AlieksieievYurii/AutoWaterPump/water-pump.png

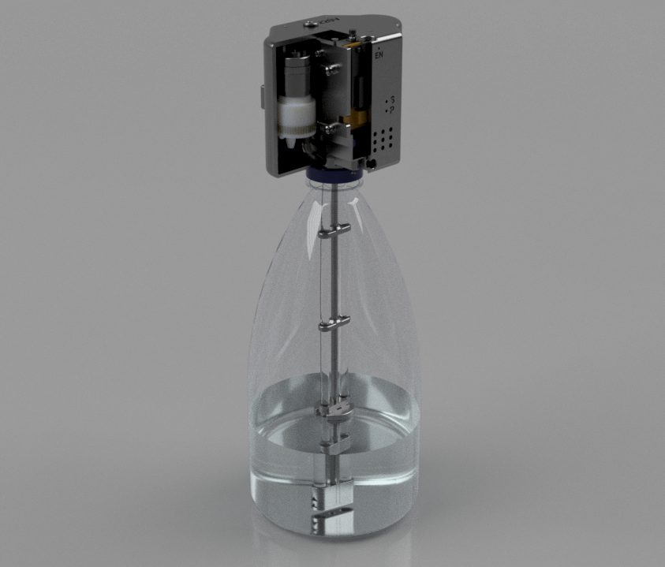
water-pump.png
