AlieksieievYurii/AutoWaterPump/parts/adapter.obj

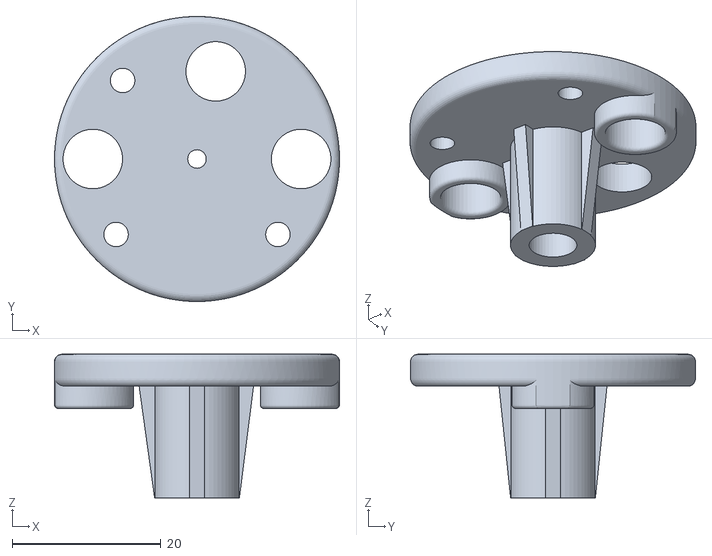
[picture p2: CAD file, 2024-06-25]
parts/adapter.obj
38.3 x 38.3 x 19.3
