AlieksieievYurii/AutoWaterPump/parts/plug-a.obj

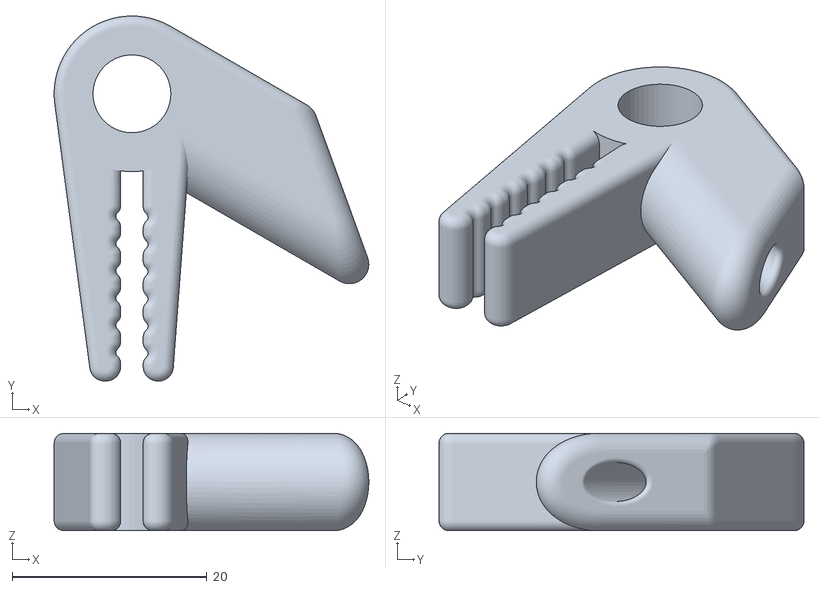
[picture p3: CAD file, 2024-06-25]
parts/plug-a.obj
32.3 x 37.5 x 10.0
