AlieksieievYurii/AutoWaterPump/parts/nozzle-b.obj

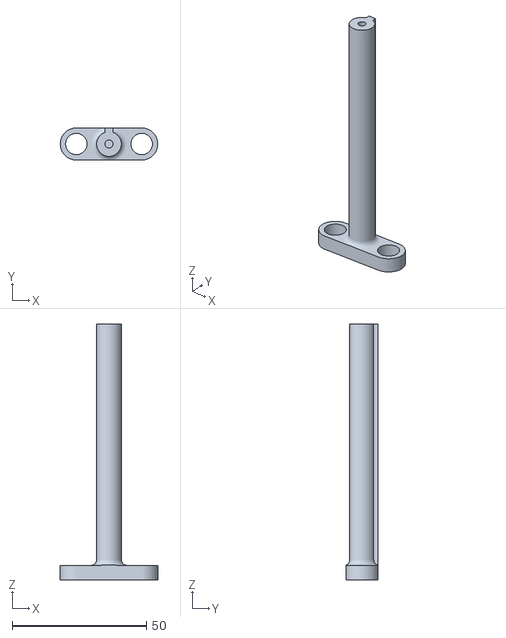
[picture p4: CAD file, 2024-06-25]
parts/nozzle-b.obj
36.4 x 12.0 x 95.5
