AlieksieievYurii/AutoWaterPump/parts/buoy.obj

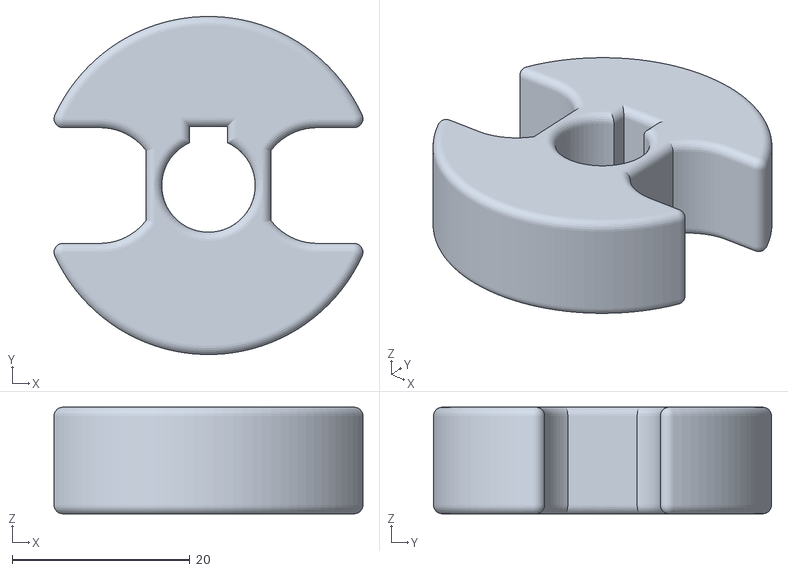
[picture p5: CAD file, 2024-06-25]
parts/buoy.obj
34.7 x 38.0 x 12.0
