AlieksieievYurii/AutoWaterPump/parts/holder.obj

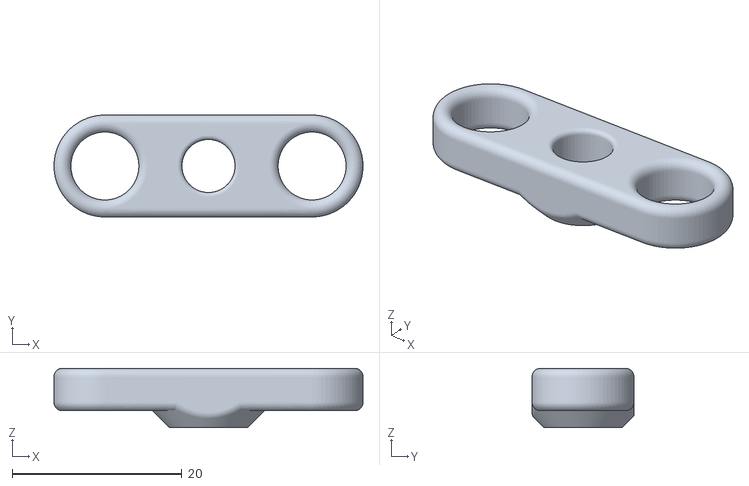
[picture p6: CAD file, 2024-06-25]
parts/holder.obj
36.4 x 12.0 x 7.00
