AlieksieievYurii/AutoWaterPump/parts/wire-adapter.obj

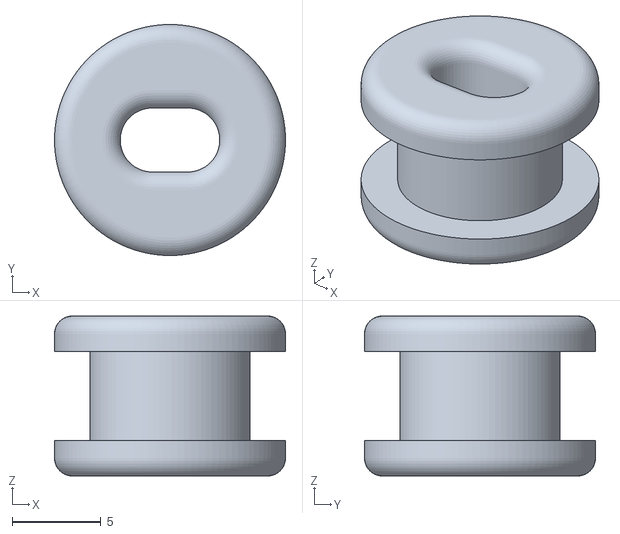
[picture p7: CAD file, 2024-06-25]
parts/wire-adapter.obj
13.0 x 13.0 x 9.00
