AlieksieievYurii/AutoWaterPump/parts/nozzle-a.obj

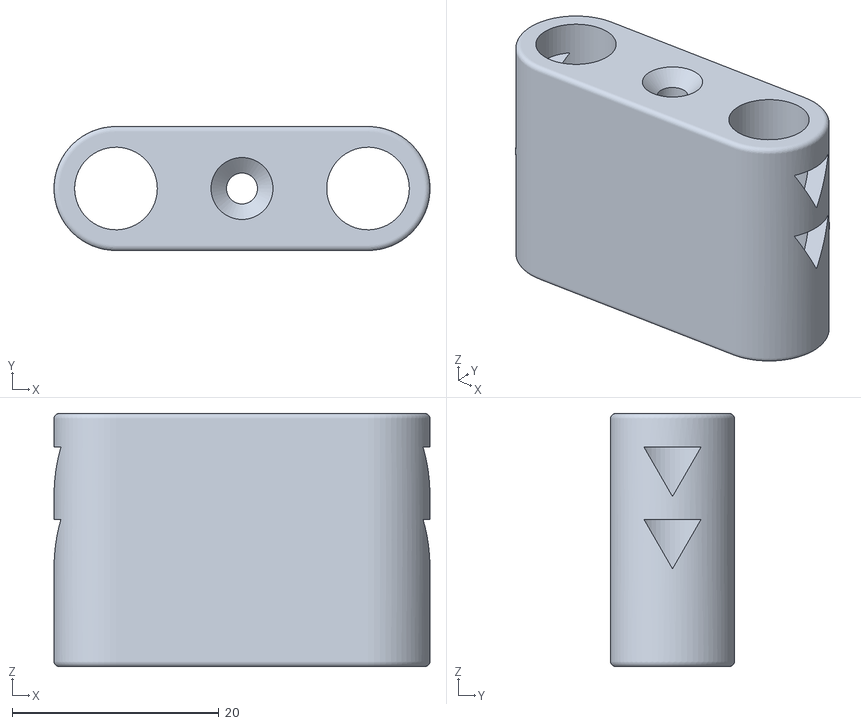
[picture p8: CAD file, 2024-06-25]
parts/nozzle-a.obj
36.4 x 12.0 x 24.5
