AlieksieievYurii/AutoWaterPump/parts/cover-d.obj

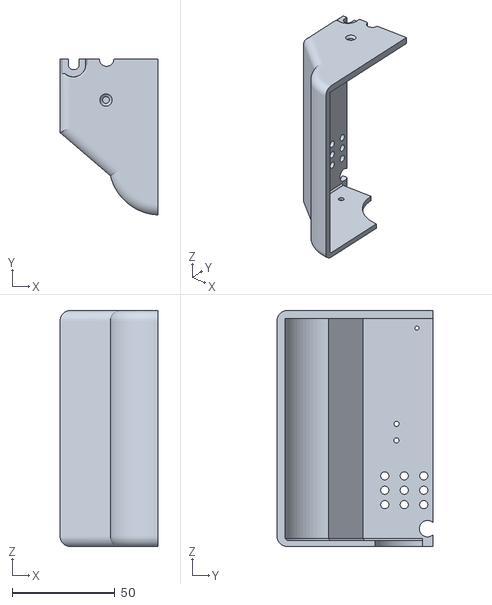
[picture p9: CAD file, 2024-06-25]
parts/cover-d.obj
47.7 x 76.0 x 115.0
