AlieksieievYurii/AutoWaterPump/parts/skeleton-c.obj

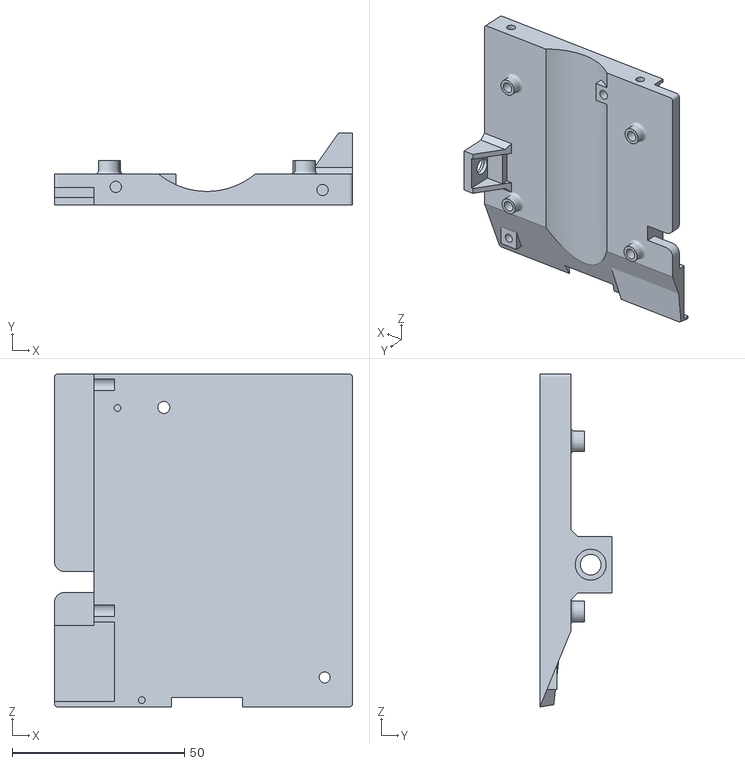
[picture p10: CAD file, 2024-06-25]
parts/skeleton-c.obj
86.5 x 21.0 x 96.6
