AlieksieievYurii/AutoWaterPump/parts/plug-b.obj

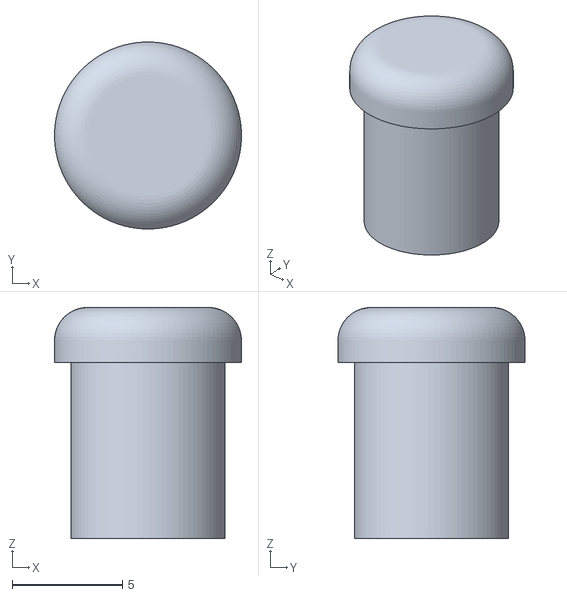
[picture p11: CAD file, 2024-06-25]
parts/plug-b.obj
8.50 x 8.50 x 10.5
