AlieksieievYurii/AutoWaterPump/parts/cover-b.obj

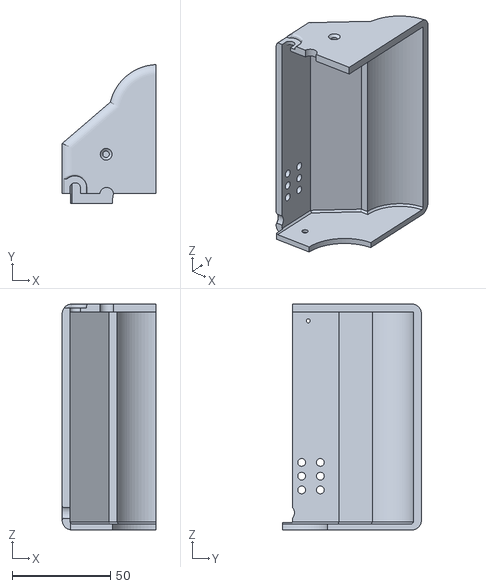
[picture p12: CAD file, 2024-06-25]
parts/cover-b.obj
47.7 x 70.7 x 115.0
