AlieksieievYurii/AutoWaterPump/parts/cover-a.obj

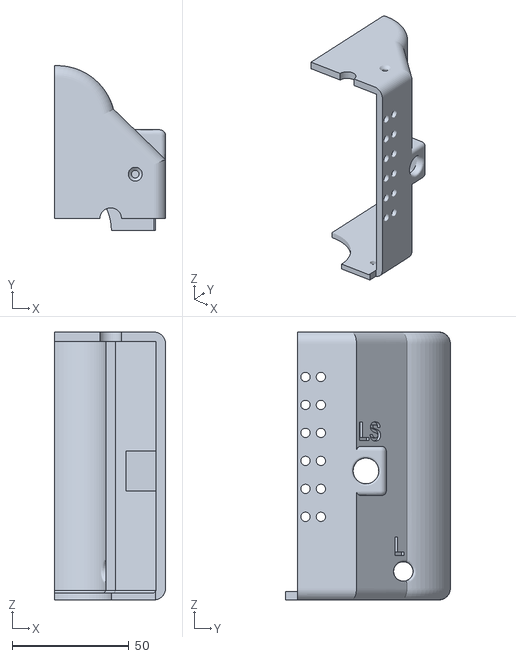
[picture p13: CAD file, 2024-06-25]
parts/cover-a.obj
47.7 x 70.7 x 115.0
