AlieksieievYurii/AutoWaterPump/parts/cover-c.obj

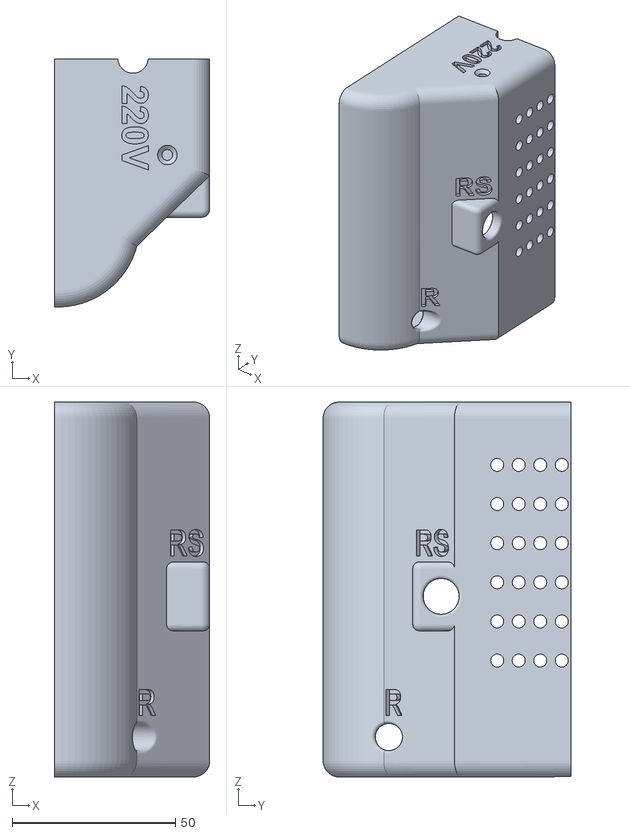
[picture p14: CAD file, 2024-06-25]
parts/cover-c.obj
47.7 x 76.0 x 115.0
