AlieksieievYurii/AutoWaterPump/parts/skeleton-a.obj

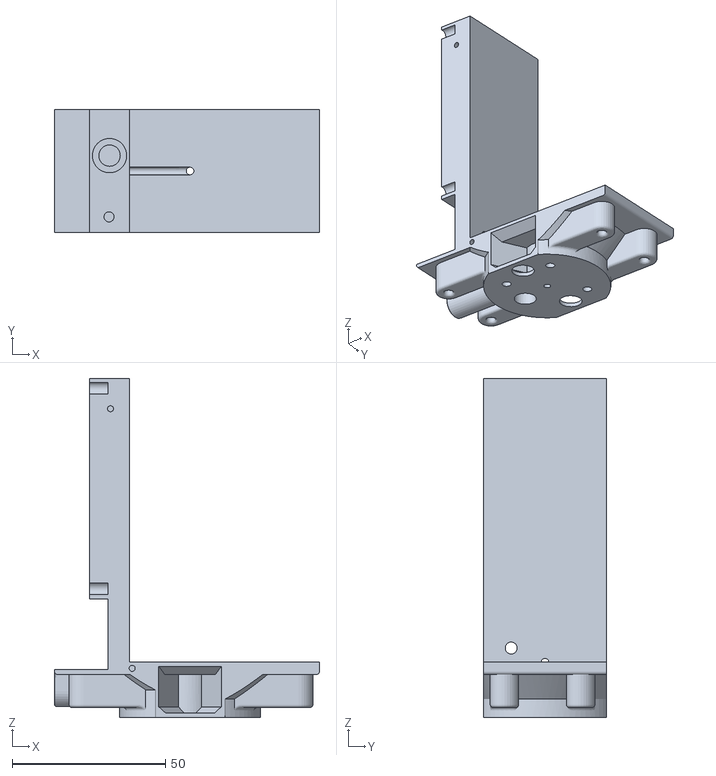
[picture p15: CAD file, 2024-06-25]
parts/skeleton-a.obj
86.5 x 40.0 x 110.6
