AlieksieievYurii/AutoWaterPump/(list of files, cad)

Other CAD files:
parts/skeleton-b.obj
