AlieksieievYurii/AutoWaterPump/(commit log)

2024-06-14 Create class responsible for motors
2024-06-14 Create class responsible for smooth state switch
2024-06-14 Create helper class to work with led/buzzer impulse
    [pulse.h]
2024-06-17 Add stop function for motor. Fix the problem regarding floating triggering
    [motor.h, src.ino]
2024-06-25 Commit parts
    [adapter.obj, buoy.obj, cover-a.obj, cover-b.obj, cover-c.obj, cover-d.obj, holder.obj, nozzle-a.obj]
2024-06-25 Add render of the water pump
2024-07-14 Fix the availability of AP during not pairing mode
    [src.ino]
2024-07-14 Add schematic
